Fudan-EGA/Ardweno/README.md

# Ardweno
- 描述：基于冰墩墩造型制作的平衡车，下半部分由两轮平衡车结构组成，控制电路位于模型内部，可自行站立和通过蓝牙遥控运动。

软硬件开发中...

见dev分支[Ardweno/tree/dev](https://github.com/Fudan-EGA/Ardweno/tree/dev)

## 硬件部分
- 电路设计开源链接：[ESP32-Ardweno](https://oshwhub.com/leannn/esp32-ping-heng-ju_copy)
 
> * 主控：ESP32DevKit开发板
> * 加速度传感器：MPU6050
> * 电机驱动：DRV8833
> * 稳压模块：MP2315，来自[DCDC-mp2315](https://oshwhub.com/sunhaoqin/dcdc_mp2315)
> * 电机：N20电机带两相霍尔编码器

元器件清单见：[BOM清单](https://github.com/Leannnnnnn/Ardweno/blob/dev/hardware/BOM%E6%B8%85%E5%8D%95.md)
