Fudan-EGA/Ardweno/software/两个文件夹说明.txt

- Ardweno 是接下来要开发的（待整理）

- TwoDriveBallanced 是前一版平衡车的程序，提供参考，能运行但程序比较乱
