Fudan-EGA/Ardweno/hardware/structure/结构设计.jpg

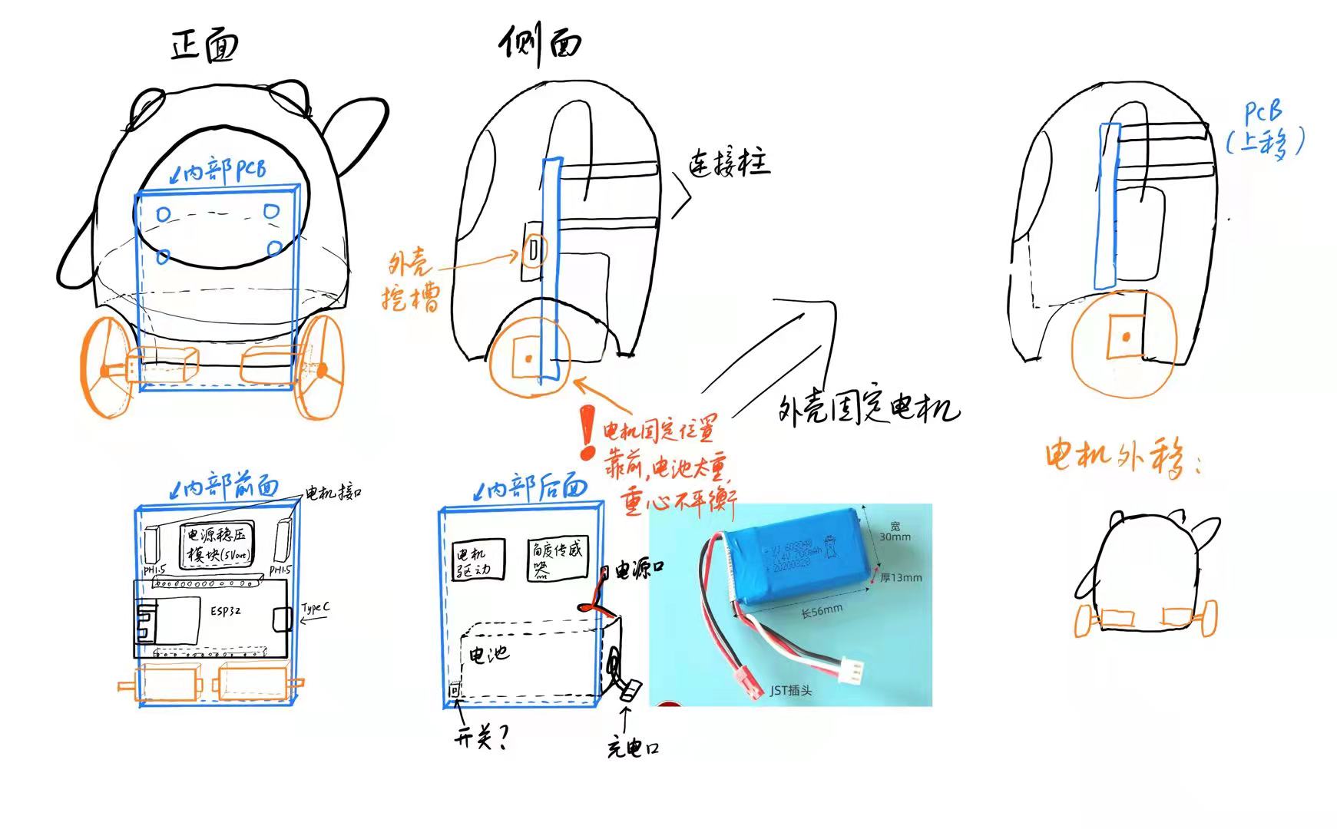
hardware/structure/结构设计.jpg
