Fudan-EGA/Ardweno/hardware/structure/结构设计（改）.jpg

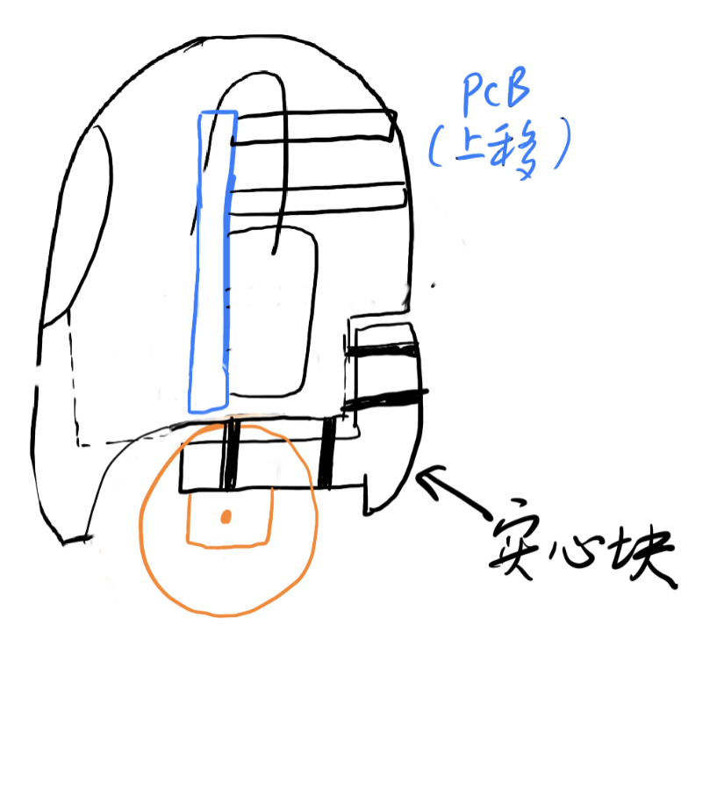
hardware/structure/结构设计（改）.jpg
