Fudan-EGA/Ardweno/hardware/BOM清单.md

### 冰墩墩平衡车材料清单

| 序号 | 名称 |标号|数量| 型号 | 备注 | 购买链接 |预估金额|
| :--: | :--: |:-:|:-:| :-: | :-: | :---:| :-: |
|1 | N20电机|-|2|-| 淘宝购买 | [链接](https://m.tb.cn/h.fpy76JL?tk=ZhCd2TnuU3G)|25*2|
|2 | 7.4V锂电池|-|1|-| 淘宝购买(附充电器) | [链接](https://m.tb.cn/h.fpySPle?tk=1hJ22TnGq8c)|35|
|3 | MPU6050加速度传感器|-|1|-| 淘宝购买 | [链接](https://m.tb.cn/h.foDb9I6?tk=cFpn2Tnu3K8)|6|
|4 | DRV8833电机驱动|-|1|-| 淘宝购买 | [链接](https://m.tb.cn/h.fMxSbMp?tk=tOQh2TnFjSQ)|5|
|5 | 5V转3.3V稳压|-|1|-| PCB贴片焊接 | [开源链接](https://oshwhub.com/sunhaoqin/dcdc_mp2315)|3|
|6 | ESP32-WROOM开发板|-|1|-| 淘宝购买 | [链接](https://m.tb.cn/h.fLDivdt?tk=DGoo2TnvwG2)|18|
|7 | 拨动开关|-|1|-| 淘宝购买 | [链接](https://m.tb.cn/h.fMxSpM7?tk=hXKw2TnE2zA)|0.5|
|8 | 冰墩墩外壳|-|1|-| 3D打印，见资料文件夹 | [链接](https://github.com/Leannnnnnn/Ardweno/tree/dev/hardware/structure)|55+15(邮+税)|
|||||||总金额：|187.5|
