Fudan-EGA/Ardweno/hardware/structure/BingDunDunUnderBody.SLDPRT

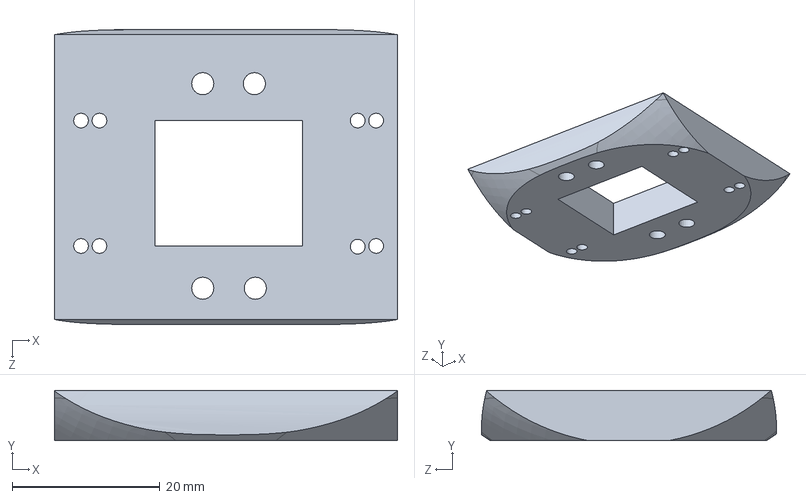
[picture p3: CAD file, 2022-03-22]
hardware/structure/BingDunDunUnderBody.SLDPRT
46.5 x 6.83 x 40.0 mm
