Fudan-EGA/Ardweno/hardware/structure/Bing Dwen Dwen v8.STL

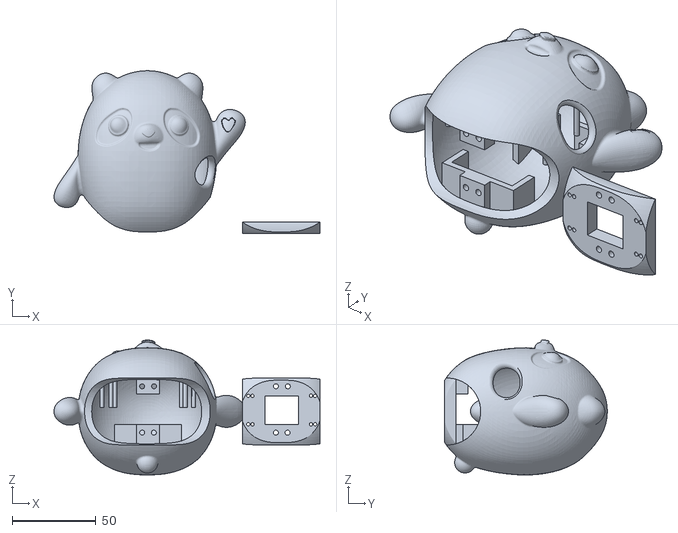
[picture p4: CAD file, 2022-03-22]
hardware/structure/Bing Dwen Dwen v8.STL
159.2 x 97.3 x 80.7
