Fudan-EGA/Ardweno/(list of files, cad)

Other CAD files:
hardware/structure/BingDunDunUnderBody.STL
hardware/structure/电机连接板图纸.SLDDRW
