Fudan-EGA/Ardweno/hardware/pcb/Schematic_ESP32- Ardweno.pdf

## MPU6050

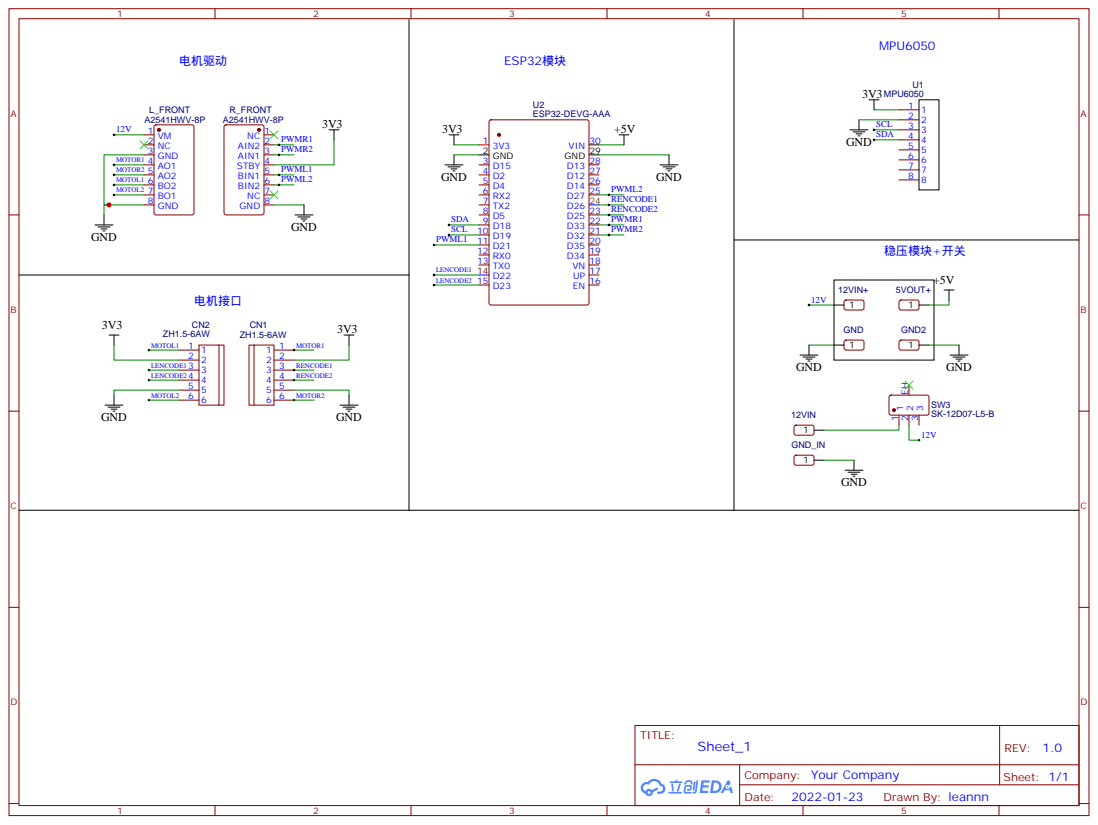
[picture p5: page 1]
