Fudan-EGA/Ardweno/(commit log)

2022-03-22 初次提交
    [Bing Dwen Dwen v8.STL, BingDunDunUnderBody.SLDPRT, BingDunDunUnderBody.STL, DC电源_MP2315S_PCB_V1.1_2022-03-07.dxf, PCB-3D.step, 下盖.stl, 电机连接板图纸.SLDDRW]
2022-03-22 Rename README.md to 文件夹说明.txt
2022-03-22 添加说明文档
2022-03-25 资料更新
    [DC电源_MP2315S_PCB_V1.1_2022-03-07.dxf, PCB-3D.step, 下盖.stl]
